KartikVij2302/Simple-ECG-Circuit/README.md

This repo contains the report of the project alaong with the LT Spice simulation of the ECG Circuit
