KartikVij2302/Simple-ECG-Circuit/ecg_final.asc

C1: cap; 20µ
C2: cap; 10n
C3: cap; 1µ
C4: cap; 1µ
C5: cap; 2.2µ
C6: cap; 10µ
C7: cap; 1µ
C8: cap; 1µ
C9: cap; 1µ
C10: cap; 2.2µ
Q1: npn; BC547B
R1: res; 1.5k
R2: res; 1.5k
R3: res; 100k
R4: res; 6.2k
R5: res; 47k
R6: res; 47k
R7: res; 100k
R8: res; 23.5k
R9: res; 40k
R10: res; 1.2k
R11: res; 3.3k
R12: res; 3.3k
R13: res; 1.5k
R14: res; 0
R15: res; 47k
R16: res; 47k
R17: res; 1.2k
R18: res; 3.3k
R19: res; 3.3k
Re1: res; 1Meg
U1: opamp2; UA741
U2: opamp2; UA741
U3: opamp2; UA741
U4: opamp2; UA741
U5: opamp2; UA741
V1: voltage; 12
V2: voltage; 12
V3: voltage; SINE(0 5m 5); AC 5m
V4: voltage; 0
Named nets: 0, Vss, Vdd, V_bpf, V_ia, Vin, Vout
.op
.lib UA741.301
Instrumentation Amplifier
(RH)
(LH)
(RL)
Active Band Pass Filter
Notch Filter
;ac dec 10000 1m 10k
High Pass BJT Filter
